ktkhshi/Pinkeybd/README.md

# Pinkeybd
"Pinkeybd" is a portable wireless split keyboard with trackball
