ktkhshi/Pinkeybd/firmware/readme.md

ファームウェアのリポジトリは[こちら](https://github.com/ktkhshi/pinkeybd-firmware)
