ktkhshi/Pinkeybd/case/Left/pinkeybd_L.step

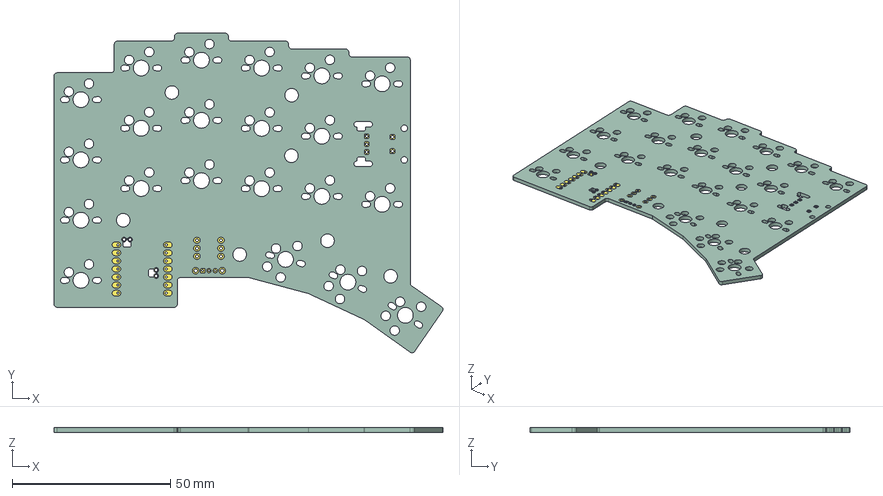
[picture p1: CAD file, 2025-10-04]
case/Left/pinkeybd_L.step
123.0 x 101.1 x 1.59 mm
pinkeybd_L_pad
pinkeybd_L_PCB
