ktkhshi/Pinkeybd/case/Right/pinkeybd_L_top_plate.step

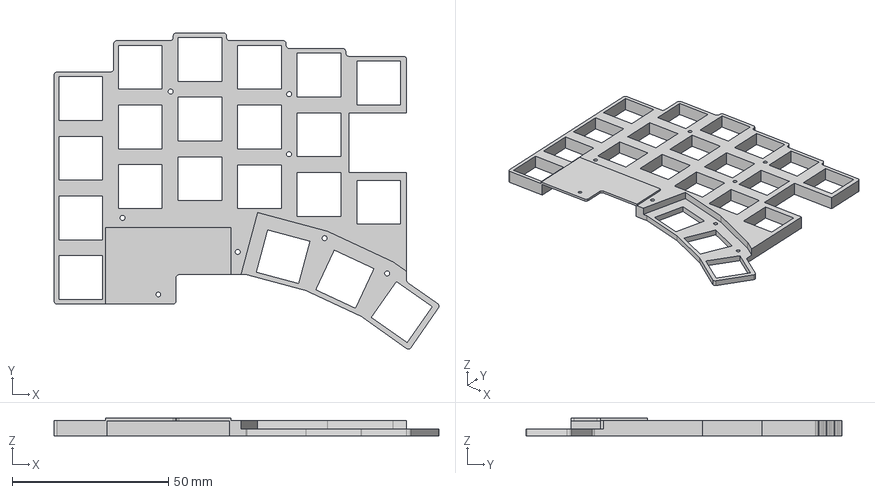
[picture p2: CAD file, 2025-10-04]
case/Right/pinkeybd_L_top_plate.step
123.0 x 101.1 x 5.70 mm
