ktkhshi/Pinkeybd/case/Right/pinkeybd_L_bottom_case.step

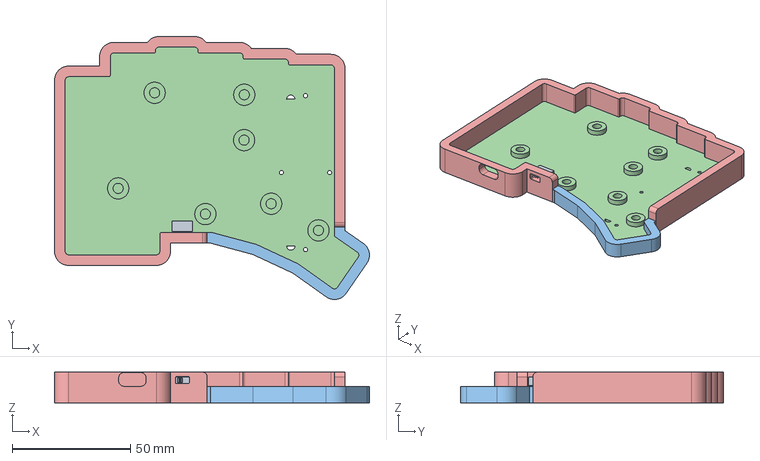
[picture p3: CAD file, 2025-10-04]
case/Right/pinkeybd_L_bottom_case.step
133.0 x 111.1 x 13.0 mm
