ktkhshi/Pinkeybd/case/Right/pinkeybd_R.step

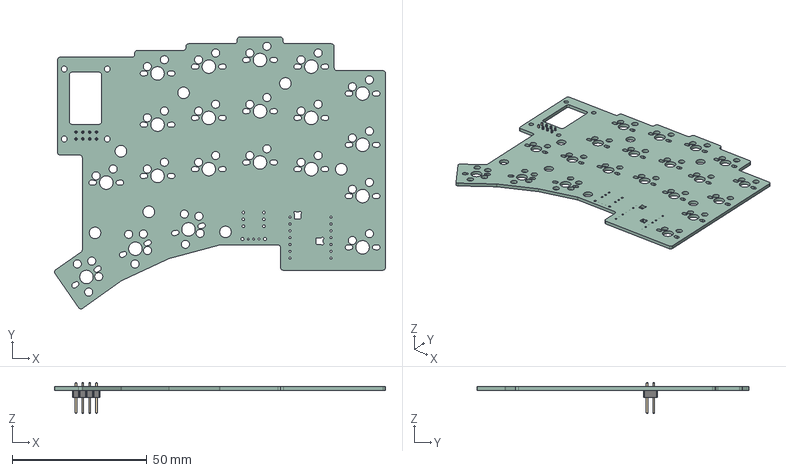
[picture p4: CAD file, 2025-10-04]
case/Right/pinkeybd_R.step
123.0 x 101.1 x 11.5 mm
PinHeader_2x04_P2.54mm_Vertical
pinkeybd_R_PCB
