ktkhshi/Pinkeybd/(list of files, cad)

Other CAD files:
case/Right/pinkeybd_L_top_plate.3mf
