ktkhshi/Pinkeybd/docs/buildguide/image/スクリーンショット 2026-01-11 185637.png

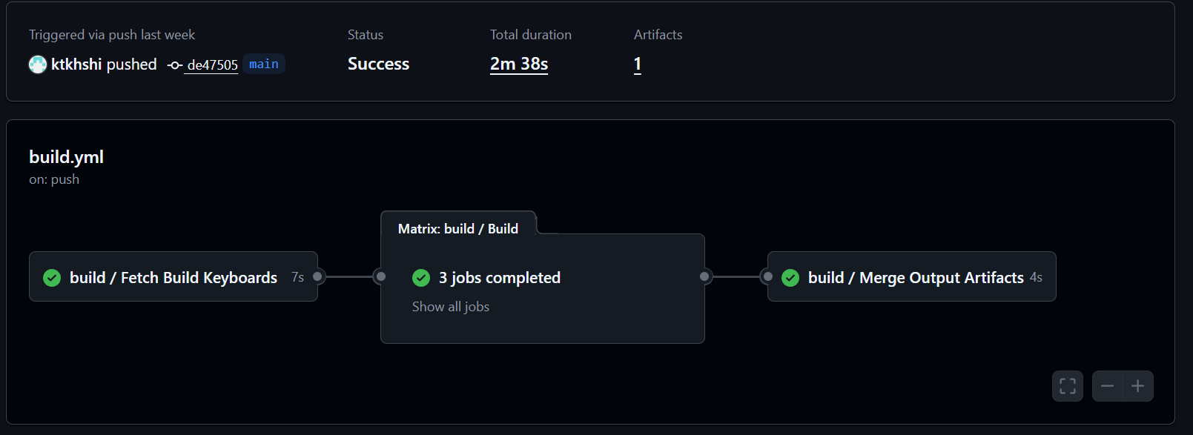
docs/buildguide/image/スクリーンショット 2026-01-11 185637.png
